SanikEmi/120VAC-60Hz-to-2.4kV-Jacob-Ladder/README.md

File "Proyecto Final - Emiliano Sanchez Godinez - Sem RCE" is the official descriptive paper for the device. IEEE Format embebed.
