SanikEmi/120VAC-60Hz-to-2.4kV-Jacob-Ladder/DIAGRAMA VARILLAS JACOBO.png

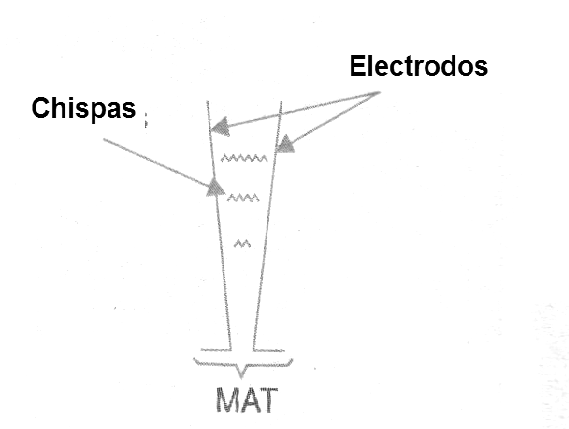
DIAGRAMA VARILLAS JACOBO.png
