SanikEmi/120VAC-60Hz-to-2.4kV-Jacob-Ladder/(list of files, drawings)

Other design files:
Control RF.ms14
Escalera JACOB CABRONA.ms14
